LeoLiu5/plantmonitor/img/3Dmapping.png

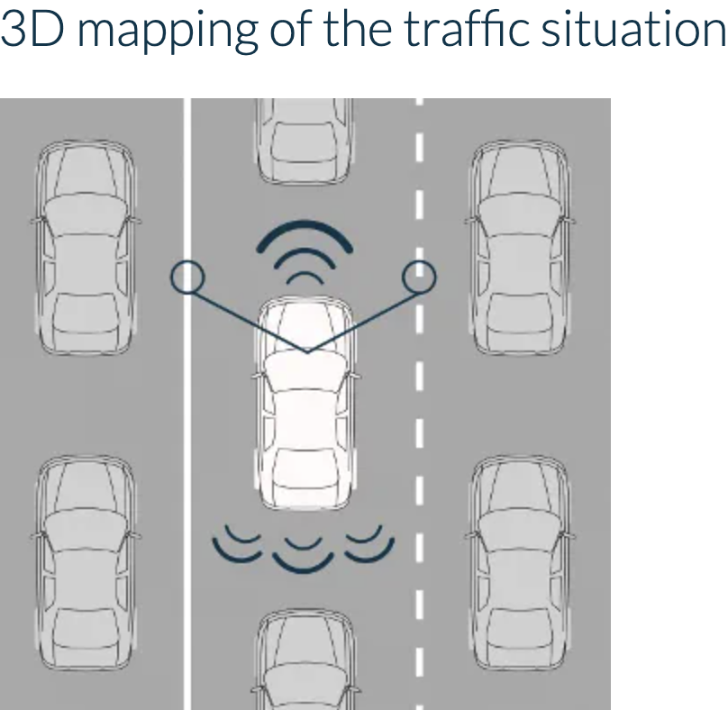
img/3Dmapping.png
