LeoLiu5/plantmonitor/img/a4.png

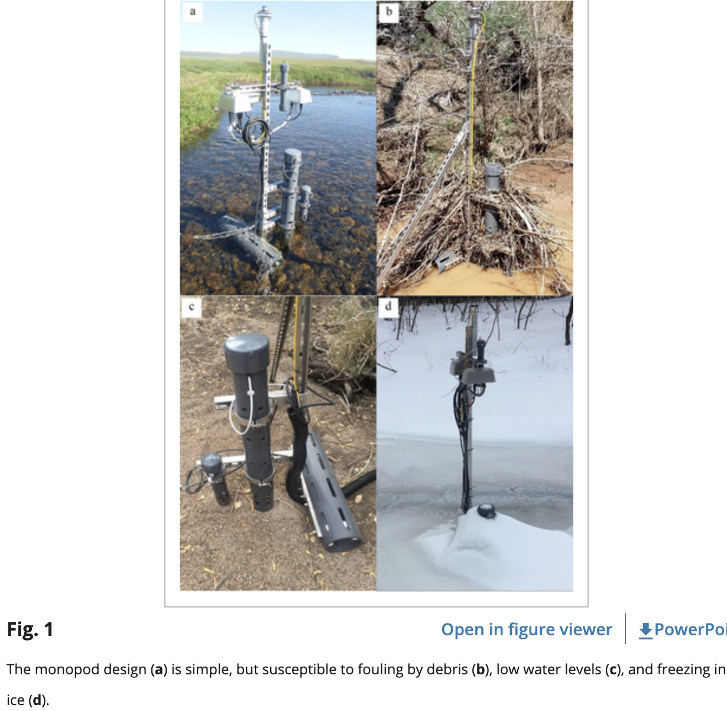
img/a4.png
