LeoLiu5/plantmonitor/img/bat1.png

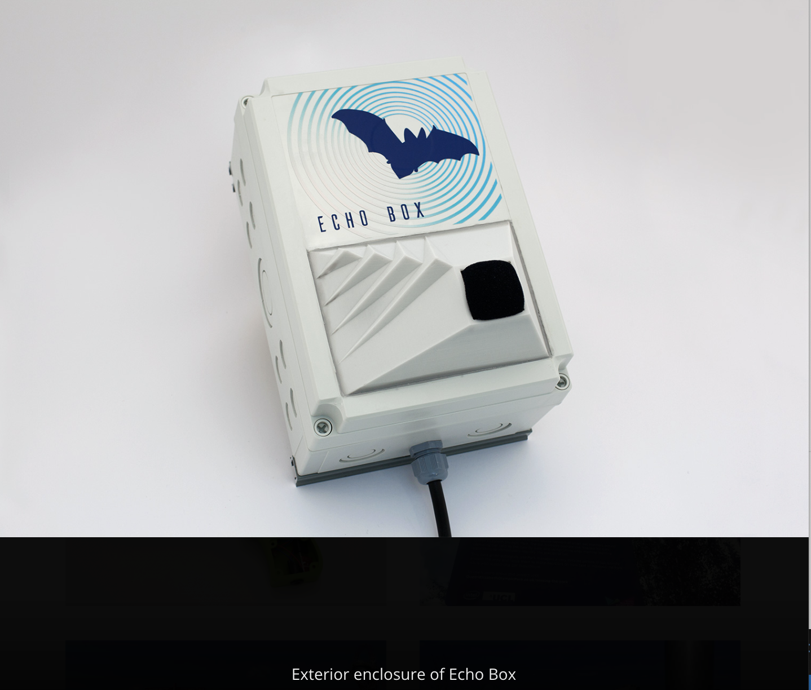
img/bat1.png
