LeoLiu5/plantmonitor/img/bat2.png

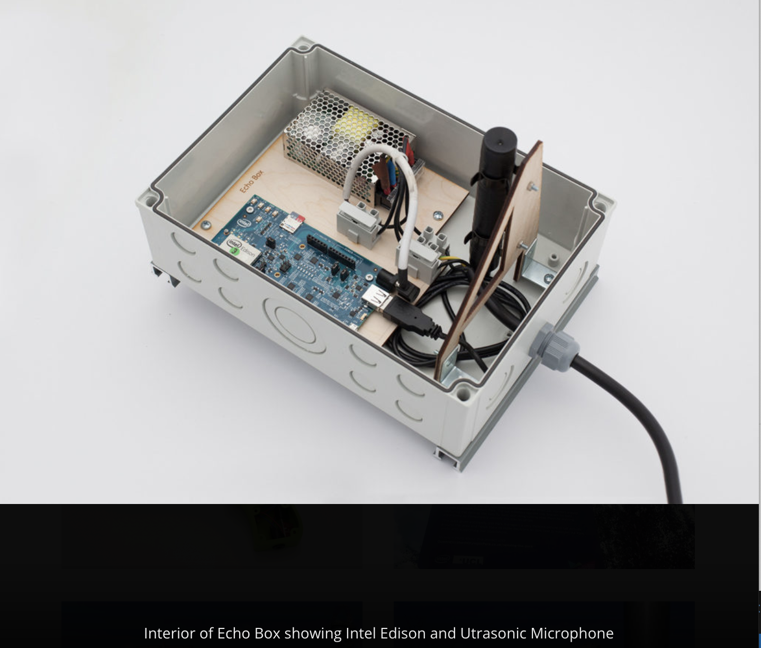
img/bat2.png
