LeoLiu5/plantmonitor/img/ConnectingDiagram.png

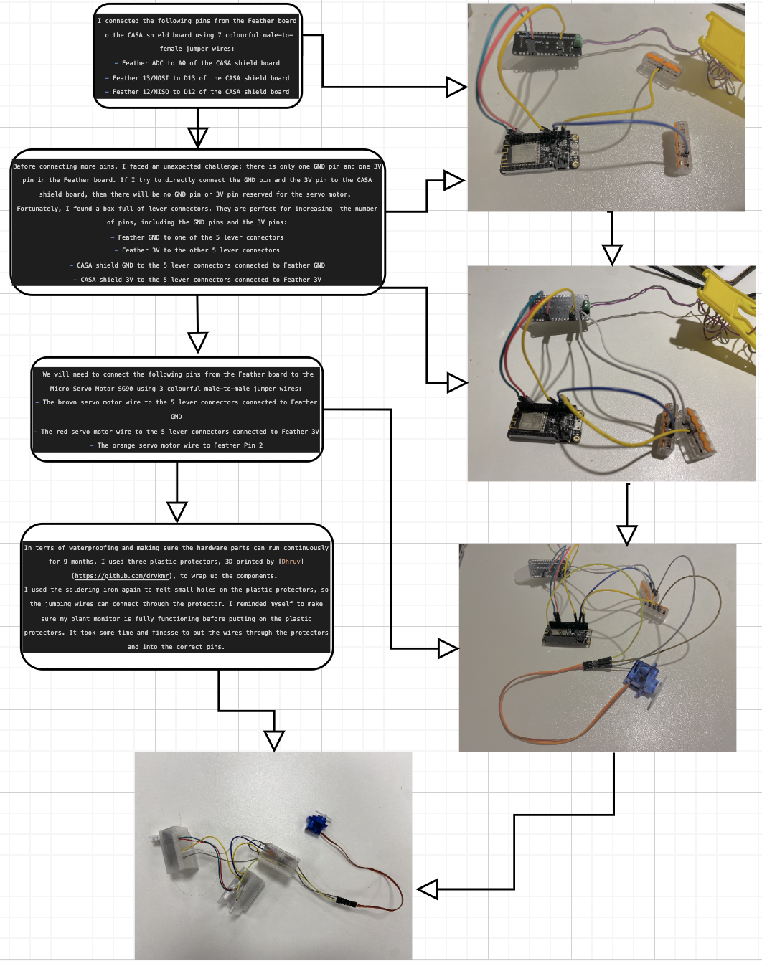
img/ConnectingDiagram.png
