LeoLiu5/plantmonitor/img/iot.jpeg

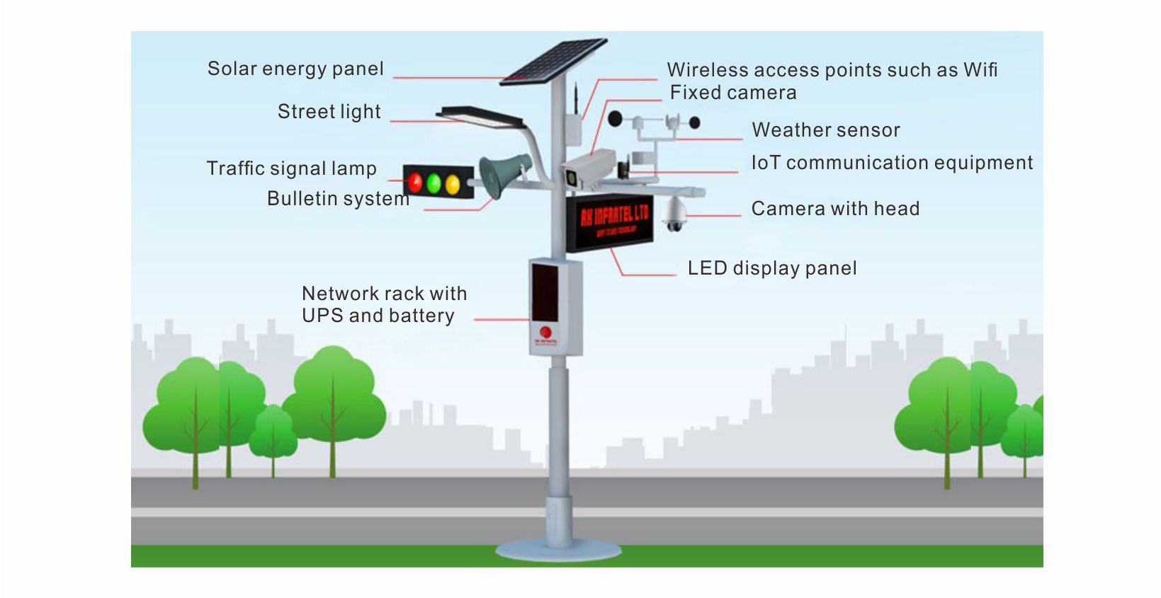
img/iot.jpeg
