LeoLiu5/plantmonitor/img/PCB.jpeg

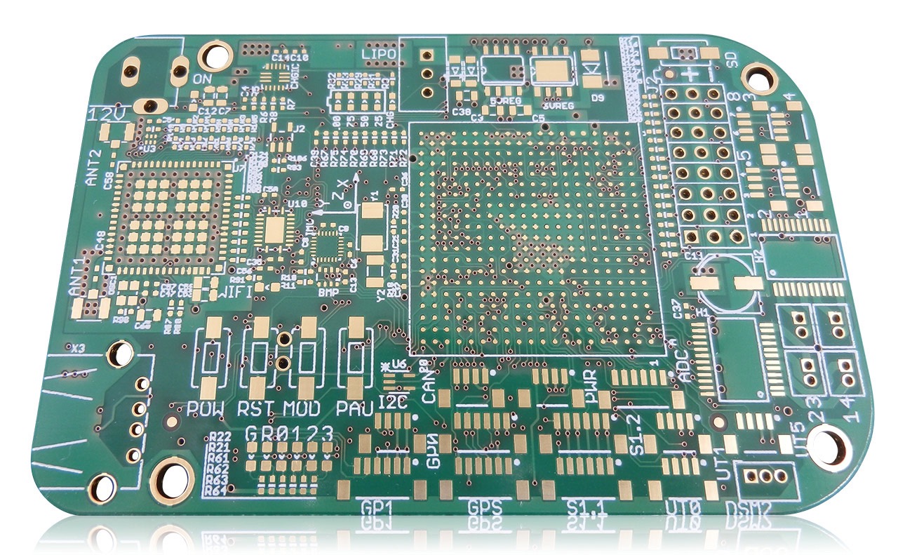
img/PCB.jpeg
