LeoLiu5/plantmonitor/img/smarthome.jpeg

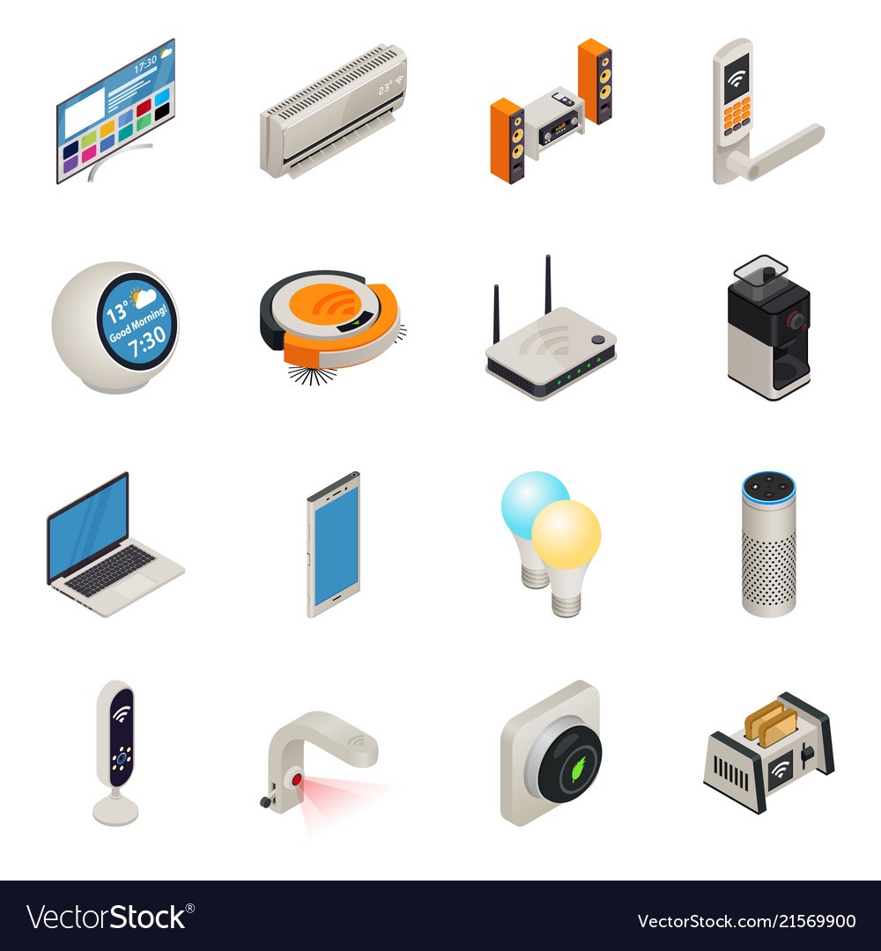
img/smarthome.jpeg
